rustychris/minictd/README.md

# minictd
Hardware and firmware for miniature, low-fi CTD
