rustychris/minictd/hardware/housings/pvc-1.25inch.fcstd

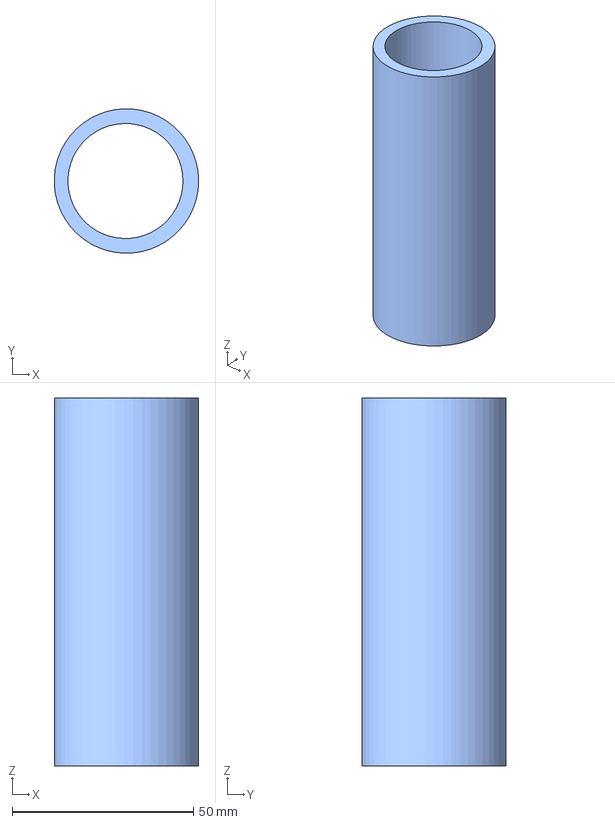
[picture p1: CAD file, 2018-12-10]
hardware/housings/pvc-1.25inch.fcstd
39.8 x 39.9 x 101.6 mm
