rustychris/minictd/hardware/parts/Battery Samsung ICR 18650 -22E.step

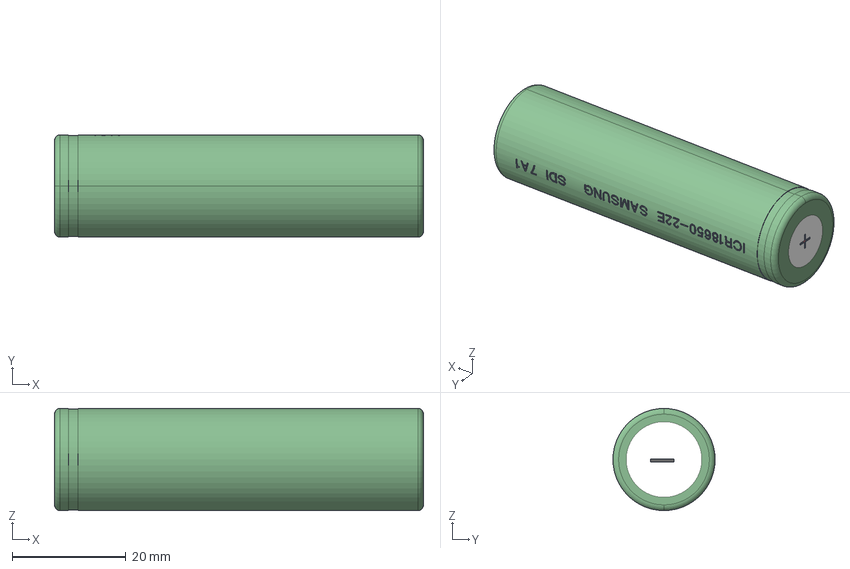
[picture p2: CAD file, 2018-11-28]
hardware/parts/Battery Samsung ICR 18650 -22E.step
65.0 x 18.0 x 18.0 mm
