rustychris/minictd/hardware/parts/Micro SD Card.STEP

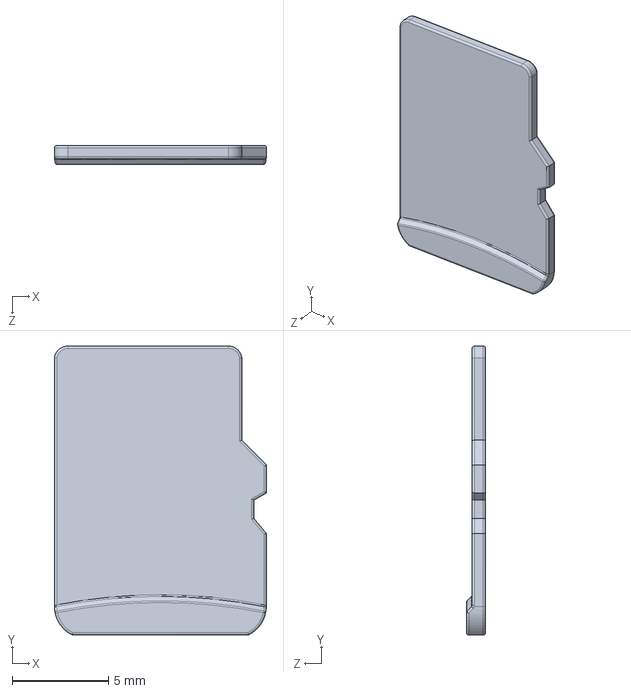
[picture p3: CAD file, 2018-11-28]
hardware/parts/Micro SD Card.STEP
11.0 x 15.0 x 1.00 mm
