rustychris/minictd/hardware/parts/keystone-PN500.STEP

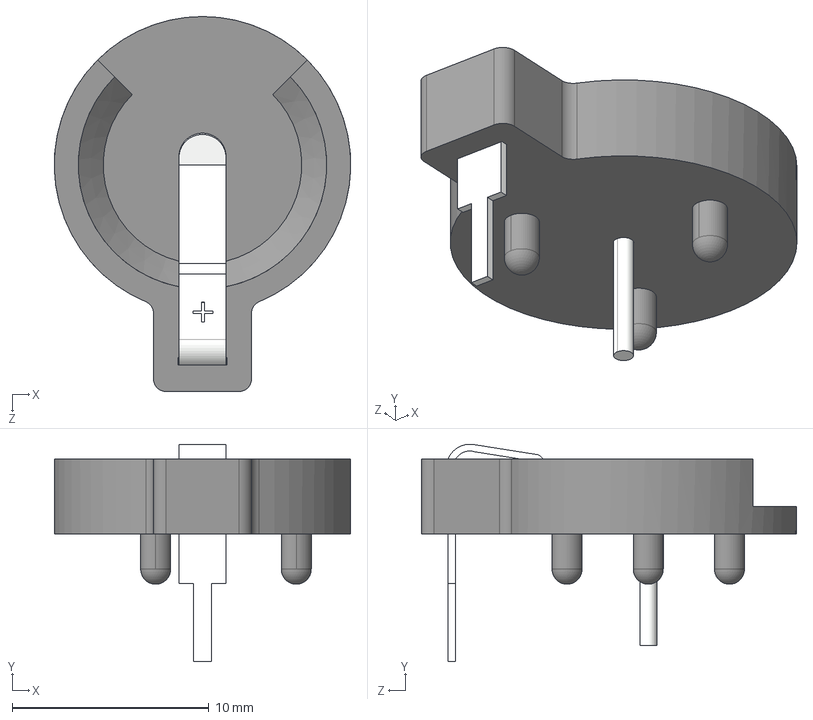
[picture p4: CAD file, 2018-11-28]
hardware/parts/keystone-PN500.STEP
15.1 x 11.0 x 19.1 mm
