rustychris/minictd/hardware/parts/Adafruit_BNO055_AP203.STEP

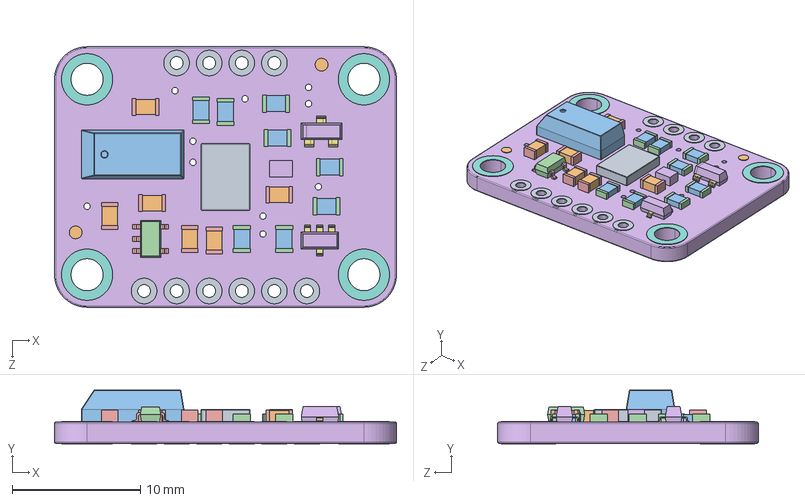
[picture p5: CAD file, 2018-11-28]
hardware/parts/Adafruit_BNO055_AP203.STEP
26.7 x 4.20 x 20.3 mm
