rustychris/minictd/hardware/parts/3727 ItsyBitsy M0.step

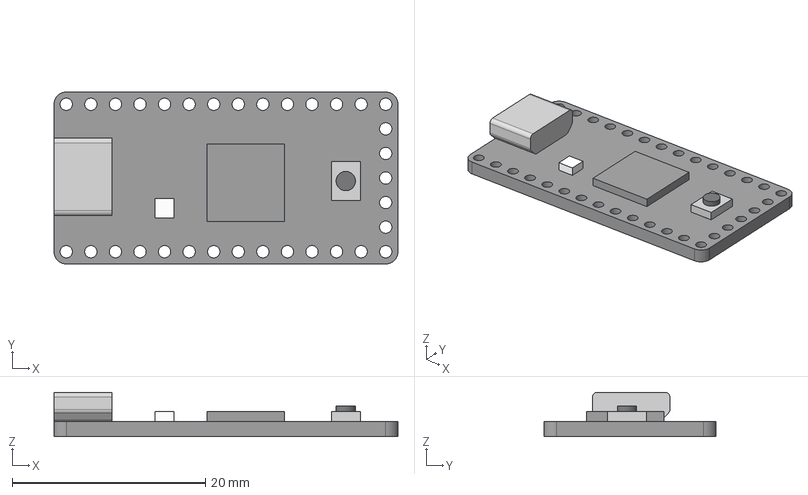
[picture p6: CAD file, 2018-11-28]
hardware/parts/3727 ItsyBitsy M0.step
35.6 x 17.8 x 4.60 mm
