rustychris/minictd/hardware/parts/DM3AT-SF-PEJM5.step

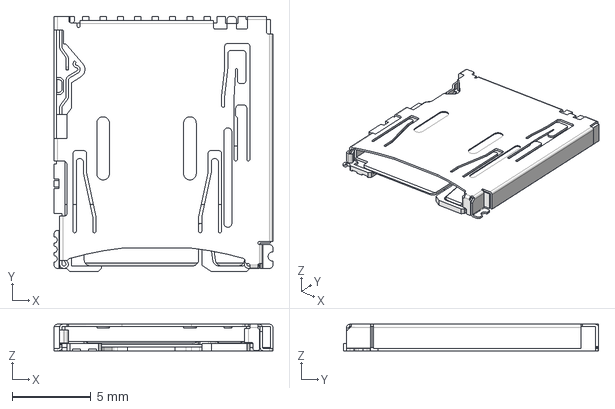
[picture p7: CAD file, 2018-11-28]
hardware/parts/DM3AT-SF-PEJM5.step
13.8 x 16.2 x 1.68 mm
