rustychris/minictd/(list of files, cad)

Other CAD files:
hardware/boards/m0_logger/keystone-PN500.STEP
