rustychris/minictd/(threads)

Thread 2 (2019-03-21):

Cruft at start of file

rustychris, 2019-03-21:
Data files often have a few samples (partial up to 4.5 lines ~ 500 bytes) at the start, like they were left in the buffer.

rustychris, 2019-03-21:
This may be fixed by using storage.cleanup() when exiting the loop instead of storage.loop().

rustychris, 2019-03-22:
Yes - fixed.

rustychris, 2019-03-22:
6635099d8f7a5920c75dd3f60d3d9767ccb64a09

Closed 2019-03-22.

Thread 3 (2019-03-22):

motor position invalid after exiting sample loop

rustychris, 2019-03-22:
the update mechanism is no longer polled, so we get wildly inaccurate negative values.
