rustychris/minictd/hardware/boards/logger/logger-pcb-back.pdf

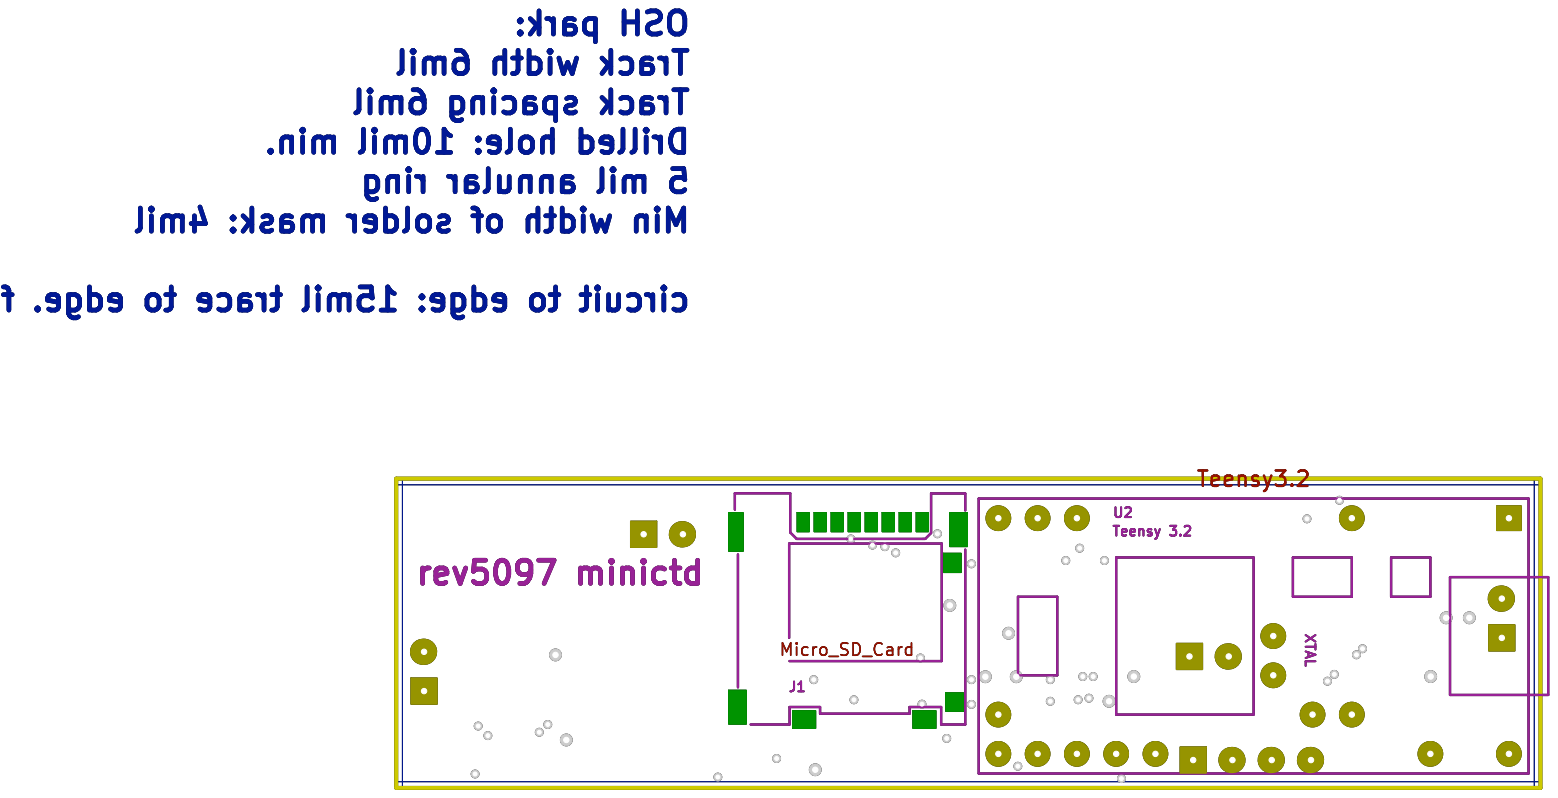
[picture p8: page 1]
