rustychris/minictd/hardware/boards/logger/logger-pcb-front.pdf

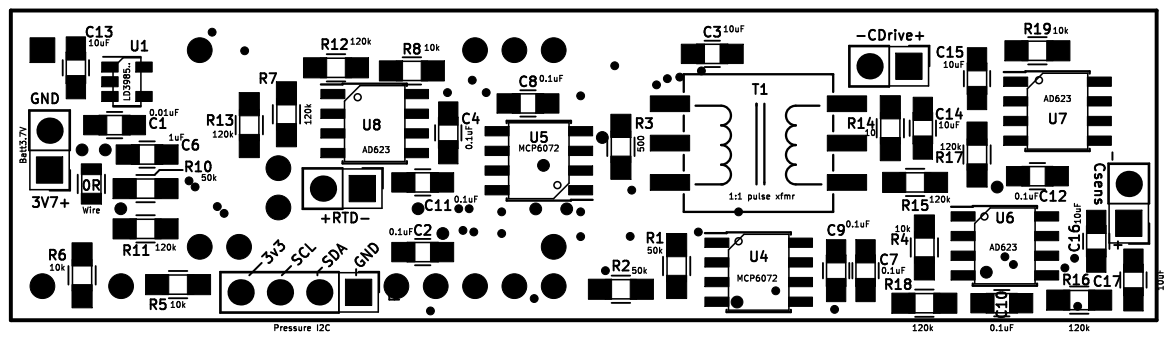
[picture p9: page 1]
