rustychris/minictd/hardware/boards/logger/logger-pcb.pdf

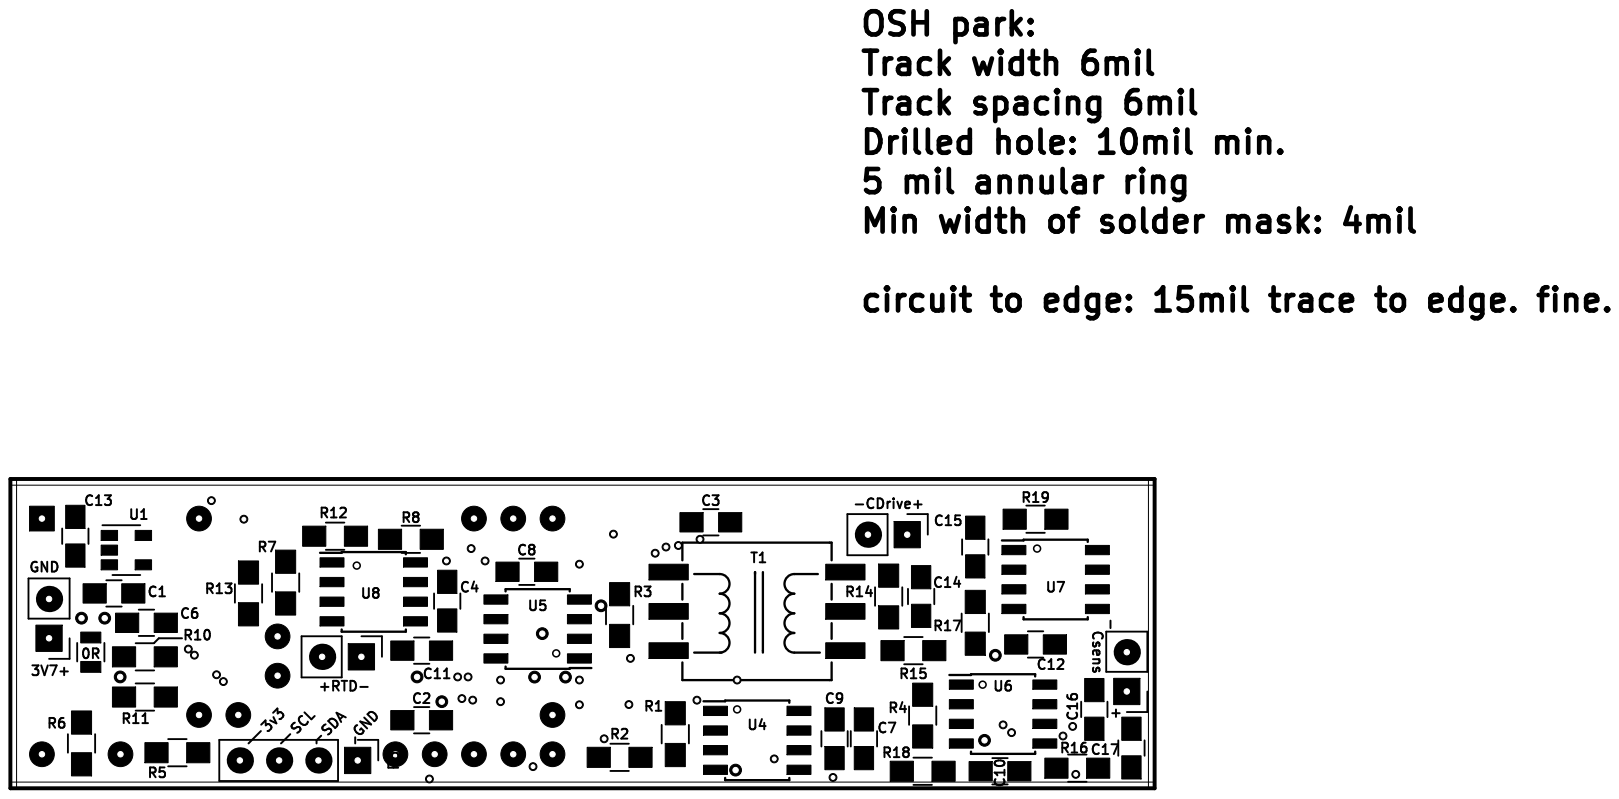
[picture p10: page 1]
