rustychris/minictd/hardware/boards/logger/logger-schematic.pdf

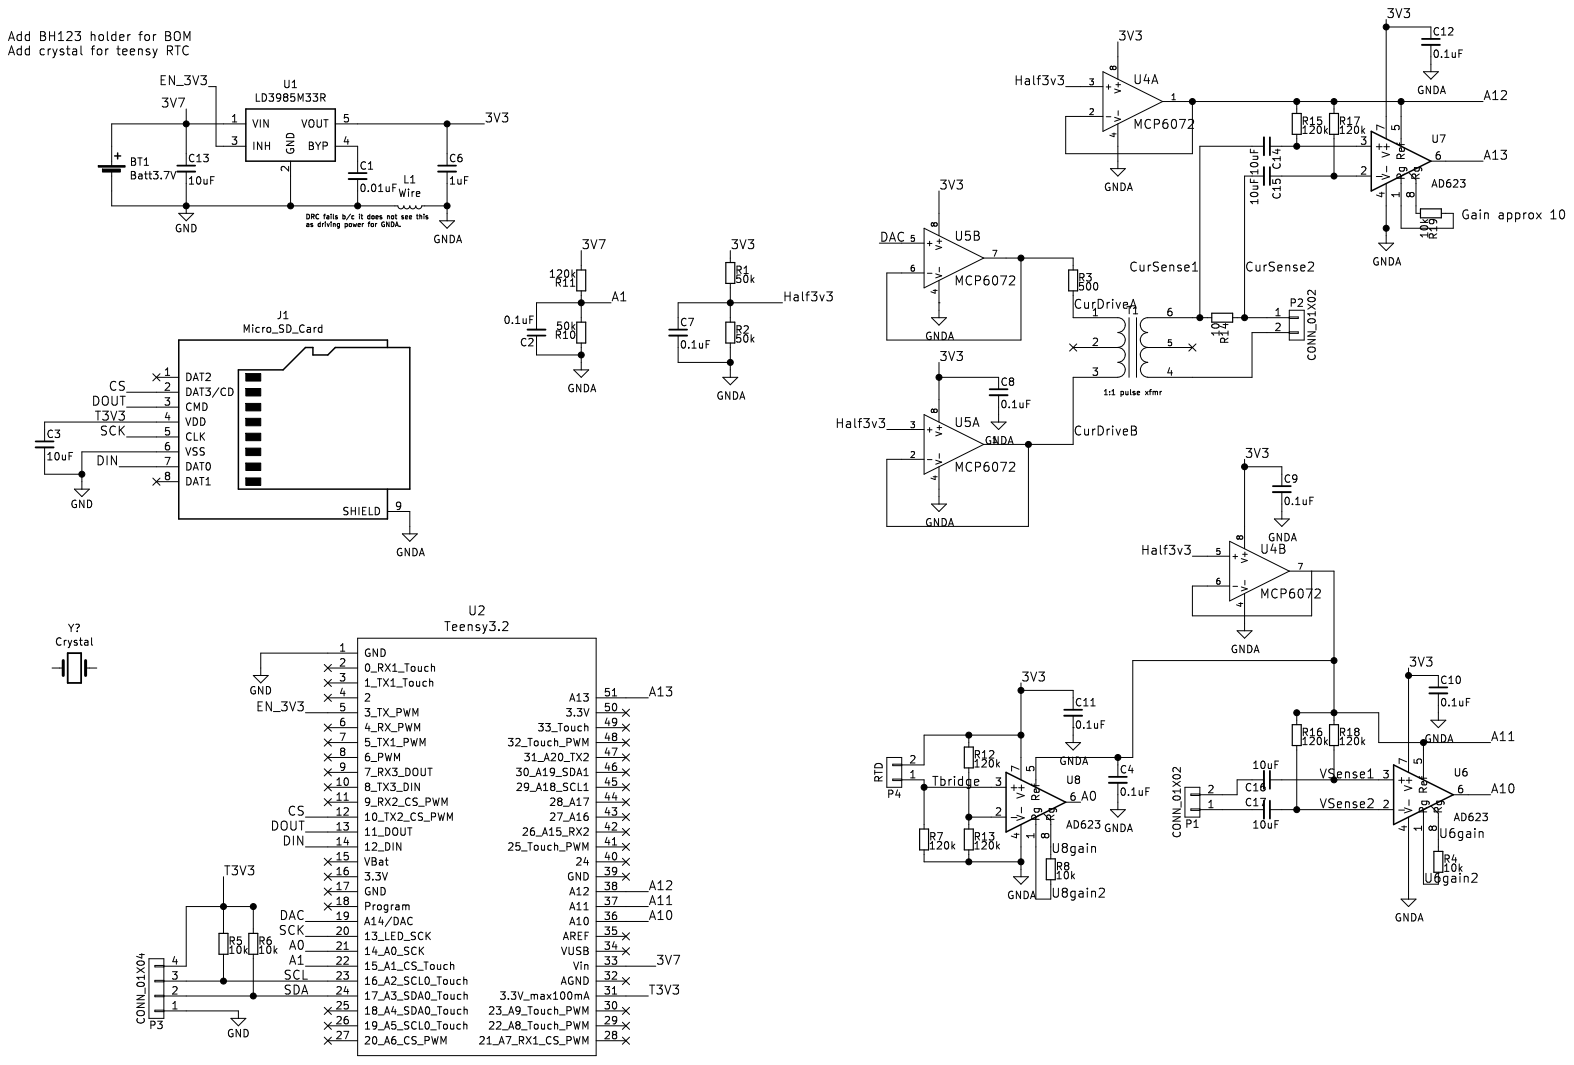
[picture p11: page 1]
