rustychris/minictd/(list of files, drawings)

Other design files:
hardware/boards/logger/logger_01.dsn
