rustychris/minictd/hardware/boards/m0_logger/m0_logger/m0_logger.kicad_pcb

## KiCad design hardware/boards/m0_logger/m0_logger/m0_logger.kicad_pcb (2018-12-20)

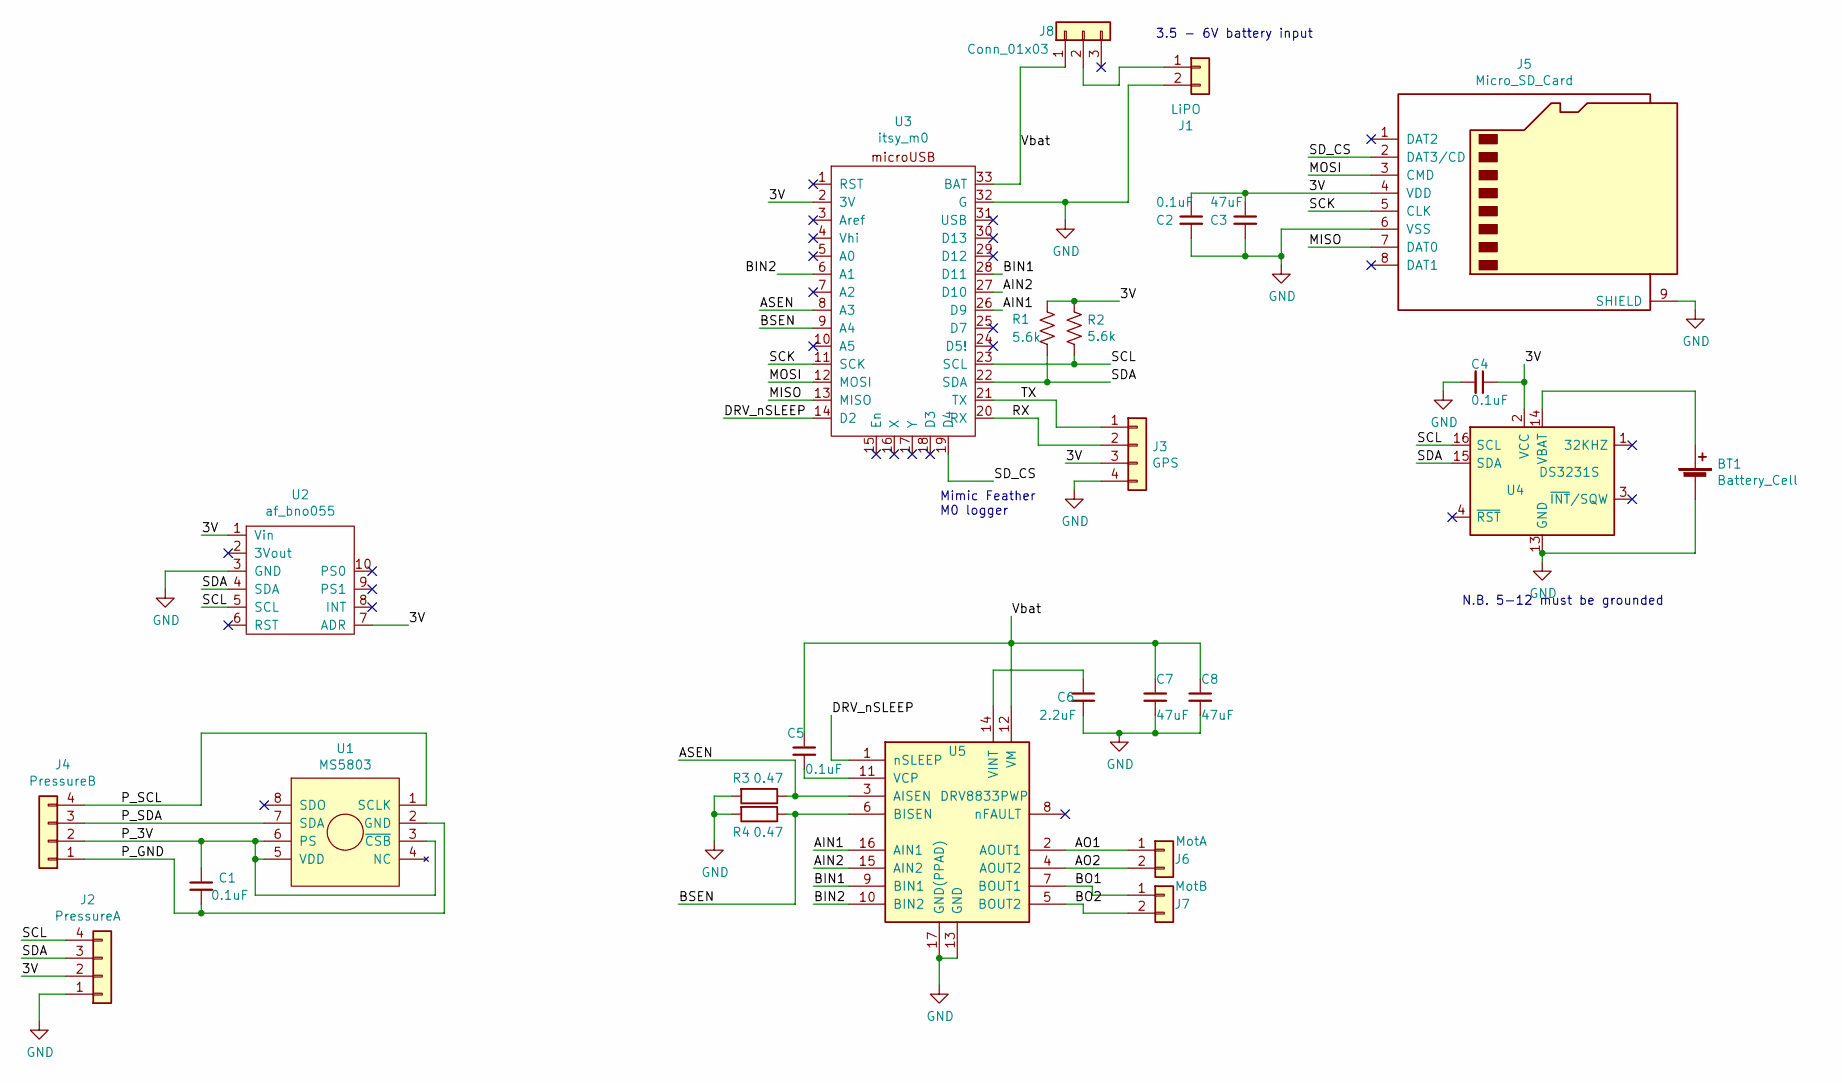
[picture p12: schematic m0_logger.sch]

Parts:
BT1: Battery_Cell; BatteryHolder_Keystone_500
C1, C2, C4, C5: 0.1uF; C_0805_2012Metric_Pad1.15x1.40mm_HandSolder
C3, C7, C8: 47uF; C_0805_2012Metric_Pad1.15x1.40mm_HandSolder
C6: 2.2uF; C_0805_2012Metric_Pad1.15x1.40mm_HandSolder
J1: LiPO; JST_PH_S2B-PH-K_1x02_P2.00mm_Horizontal
J2: PressureA; Molex_PicoBlade_53047-0810_1x04_P1.25mm_Vertical
J3: GPS; Molex_PicoBlade_53047-0810_1x04_P1.25mm_Vertical
J4: PressureB; PinHeader_1x04_P2.54mm_Vertical
J5: Micro_SD_Card; microSD_HC_Hirose_DM3AT-SF-PEJM5
J6: MotA; Molex_PicoBlade_53047-0410_1x02_P1.25mm_Vertical
J7: MotB; Molex_PicoBlade_53047-0410_1x02_P1.25mm_Vertical
J8: Conn_01x03; PinHeader_1x03_P2.54mm_Vertical
R1, R2: 5.6k; R_0805_2012Metric_Pad1.15x1.40mm_HandSolder
R3, R4: 0.47; R_0805_2012Metric_Pad1.15x1.40mm_HandSolder
U1: MS5803; ms5803_rh
U2: af_bno055; afBNO055
U3: itsy_m0; ItsyBitsyM0
U4: DS3231S; SOIC-16W_7.5x10.3mm_P1.27mm
U5: DRV8833PWP; HTSSOP-16-1EP_4.4x5mm_P0.65mm_EP3.4x5mm_Mask2.46x2.31mm_The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

Connections:
/3V: C2.1, C3.1, C4.1, J2.2, J3.3, J5.4 (VDD), R1.1, R2.1, U2.1 (Vin), U2.7 (ADR), U3.2 (3V), U4.2 (VCC)
/AIN1: U3.26 (D9), U5.16 (AIN1)
/AIN2: U3.27 (D10), U5.15 (AIN2)
/AO1: J6.1, U5.2 (AOUT1)
/AO2: J6.2, U5.4 (AOUT2)
/ASEN: R3.1, U3.8 (A3), U5.3 (AISEN)
/BIN1: U3.28 (D11), U5.9 (BIN1)
/BIN2: U3.6 (A1), U5.10 (BIN2)
/BO1: J7.1, U5.7 (BOUT1)
/BO2: J7.2, U5.5 (BOUT2)
/BSEN: R4.1, U3.9 (A4), U5.6 (BISEN)
/DRV_nSLEEP: U3.14 (D2), U5.1 (nSLEEP)
/MISO: J5.7 (DAT0), U3.13 (MISO)
/MOSI: J5.3 (CMD), U3.12 (MOSI)
/P_3V: C1.1, J4.2, U1.3 (~CSB~), U1.5 (VDD), U1.6 (PS); also elsewhere on the board
/P_GND: C1.2, J4.1, U1.2 (GND); also elsewhere on the board
/P_SCL: J4.4, U1.1 (SCLK); also elsewhere on the board
/P_SDA: J4.3, U1.7 (SDA); also elsewhere on the board
/RX: J3.2, U3.20 (RX)
/SCK: J5.5 (CLK), U3.11 (SCK)
/SCL: J2.4, R2.2, U2.5 (SCL), U3.23 (SCL), U4.16 (SCL)
/SDA: J2.3, R1.2, U2.4 (SDA), U3.22 (SDA), U4.15 (SDA)
/SD_CS: J5.2 (DAT3/CD), U3.19 (D4)
/TX: J3.1, U3.21 (TX)
/Vbat: C5.1, C7.1, C8.1, J8.1, U3.33 (BAT), U5.12 (VM)
GND: BT1.2 (-), C2.2, C3.2, C4.2, C6.2, C7.2, C8.2, J1.2, J2.1, J3.4, J5.6 (VSS), J5.9 (SHIELD), R3.2, R4.2, U2.3 (GND), U3.32 (G), U4.5 (GND), U4.6 (GND), U4.7 (GND), U4.8 (GND), U4.9 (GND), U4.10 (GND), U4.11 (GND), U4.12 (GND), U4.13 (GND), U5.13 (GND), U5.17 (GND(PPAD))
unnamed: BT1.1 (+), U4.14 (VBAT)
unnamed: C5.2, U5.11 (VCP)
unnamed: C6.1, U5.14 (VINT)
unnamed: J1.1, J8.2

Notes on the sheet:
N.B. 5-12 must be grounded
Mimic Feather M0 logger
3.5 - 6V battery input

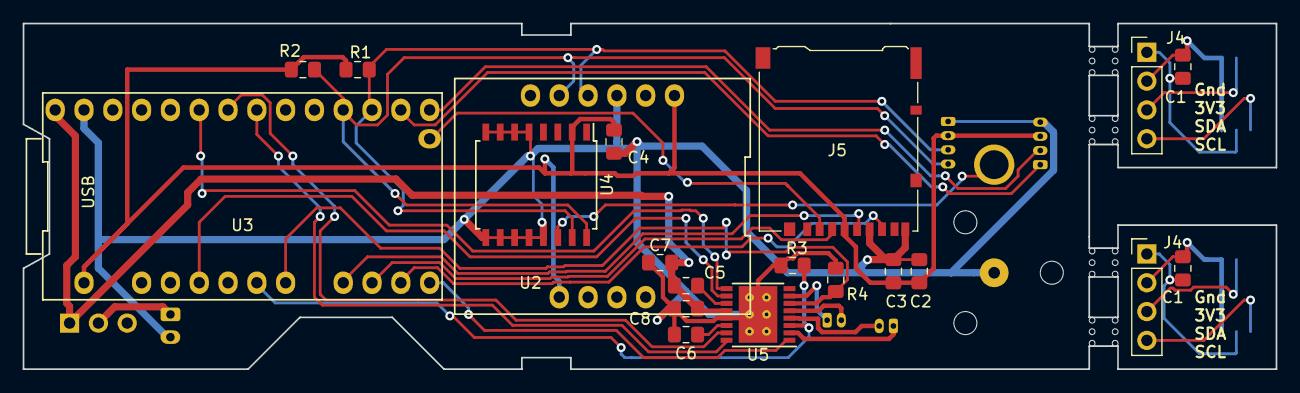
[picture p13: board m0_logger.kicad_pcb from above]

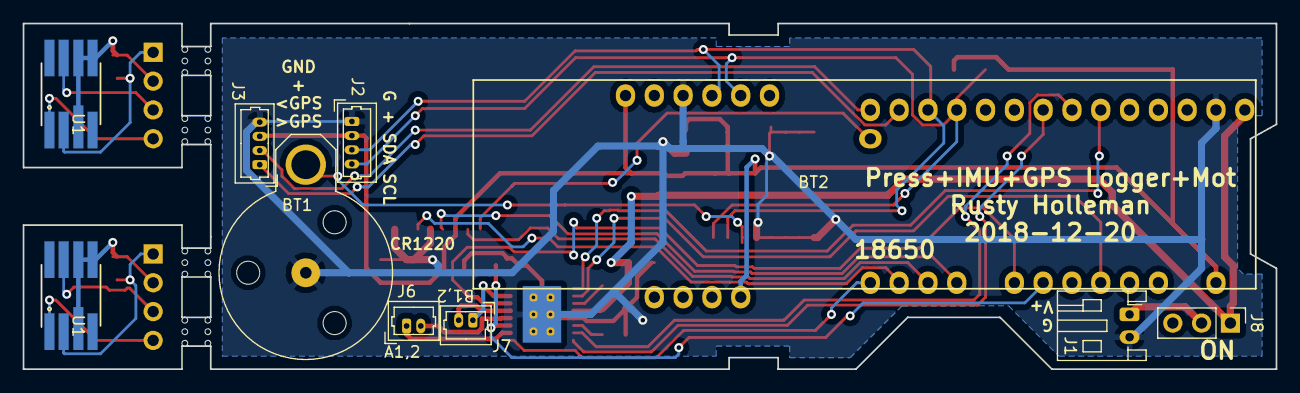
[picture p14: board m0_logger.kicad_pcb from below]

Board: 2 copper layers, 110.5 x 30.5 mm, 30 parts (10 on the bottom side), 30 nets.

Other parts of the board:
BT2: 18650, protected; af18650_outline
C1#2: 0.1uF; C_0805_2012Metric_Pad1.15x1.40mm_HandSolder
J4#2: PressureB; PinHeader_1x04_P2.54mm_Vertical
U1#2: MS5803; ms5803_rh

Their connections:
/P_3V: C1#2.1, J4#2.2, U1#2.3, U1#2.5, U1#2.6; also elsewhere on the board
/P_GND: C1#2.2, J4#2.1, U1#2.2; also elsewhere on the board
/P_SCL: J4#2.4, U1#2.1; also elsewhere on the board
/P_SDA: J4#2.3, U1#2.7; also elsewhere on the board
