rustychris/minictd/hardware/boards/logger/logger_01.kicad_pcb

## KiCad design hardware/boards/logger/logger_01.kicad_pcb (2017-07-04)

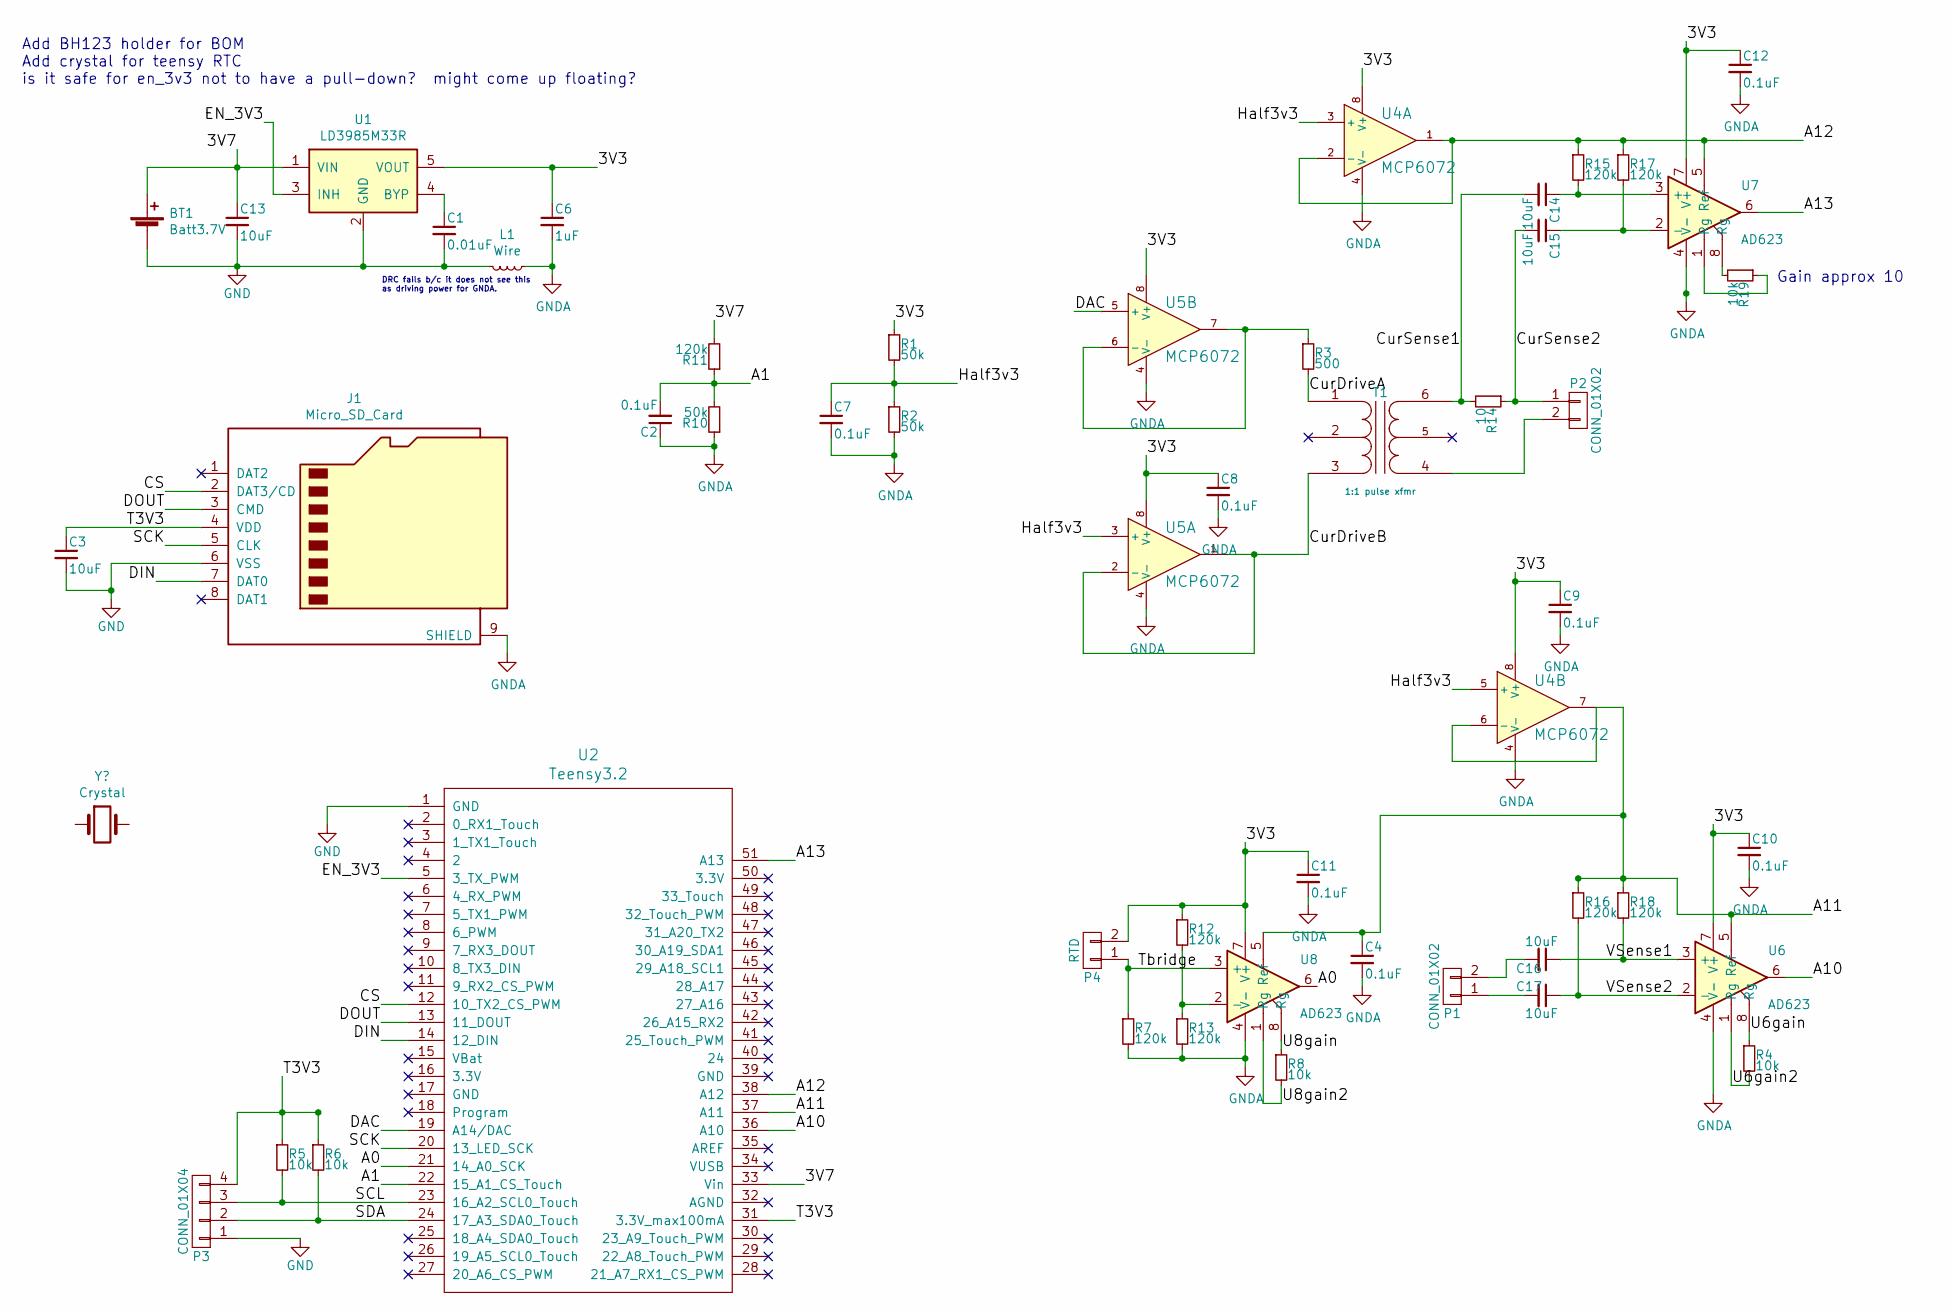
[picture p15: schematic logger_01.sch]

Parts:
BT1: Batt3.7V; Pin_Header_Straight_1x02_Pitch2.54mm
C1: 0.01uF; C_0805_HandSoldering; part_num CC0805KRX7R9BB103; digikey_num 311-1136-1-ND
C2, C7: 0.1uF; C_0805_HandSoldering; part_num 08055C104KAT2A; digikey_num 478-1395-1-ND
C3, C13, C14, C15, C16, C17: 10uF; C_0805_HandSoldering; part_num GRM21BR61E106KA73L; digikey_num 490-5523-1-ND
C4, C8, C9, C10, C11, C12: 0.1uF; C_0805_HandSoldering; part_num 08055C104KAT2A
C6: 1uF; C_0805_HandSoldering; part_num GRM21BR61E106KA73L; digikey_num 490-5523-1-ND
J1: Micro_SD_Card; molex5031821852; part_num 5031821852; digikey_num WM12834CT-ND
L1: Wire; R_0805
P1, P2: CONN_01X02; Pin_Header_Straight_1x02_Pitch2.54mm
P3: CONN_01X04; Pin_Header_Straight_1x04_Pitch2.54mm; part_num S1011EC-12-ND; digikey_num PRPC012SAAN-RC
P4: RTD; Pin_Header_Straight_1x02_Pitch2.54mm
R1, R2, R10: 50k; R_0805_HandSoldering; part_num RT0805DRE0722K1L; digikey_num 311-2825-1-ND
R3: 500; R_0805_HandSoldering; part_num RR1220P-471-D; digikey_num RR12P470DCT-ND
R4, R6, R8, R19: 10k; R_0805_HandSoldering; part_num RT0805DRD0712K1L
R5: 10k; R_0805_HandSoldering; part_num RT0805DRD0712K1L; digikey_num 311-2703-1-ND
R7, R12, R13, R15, R16, R17, R18: 120k; R_0805_HandSoldering; part_num RT0805DRD07120KL; digikey_num 311-2702-1-ND
R11: 120k; R_0805_HandSoldering; part_num RT0805DRE0722K1L; digikey_num 311-2825-1-ND
R14: 10; R_0805_HandSoldering; part_num RT0805DRD0710RL; digikey_num 311-2700-1-ND
T1: 1:1 pulse xfmr; 6pin_pulse_transformer; part_num 78253/55JC; digikey_num 811-2415-ND
U1: LD3985M33R; SOT-23-5; part_num LD3985M33R; digikey_num 497-3504-1-ND
U2: Teensy3.2; Teensy32_for_logger
U4: MCP6072; SOIC-8_3.9x4.9mm_Pitch1.27mm; part_num MCP6072-E/SN; digikey MCP6072-E/SN-ND
U5: MCP6072; SOIC-8_3.9x4.9mm_Pitch1.27mm; part_num MCP6072-E/SN; digikey_num MCP6072-E/SN-ND
U6, U7, U8: AD623; SOIC-8_3.9x4.9mm_Pitch1.27mm; part_num AD623ARZ; digikey_num AD623ARZ-ND

Connections:
/3V3: C6.1, C8.1, C9.1, C10.1, C11.1, C12.1, P4.2, R1.1, R12.1, U1.5 (VOUT), U4.8 (V+), U5.8 (V+), U6.7 (V+), U7.7 (V+), U8.7 (V+)
/3V7: BT1.1 (+), C13.1, R11.2, U1.1 (VIN), U2.33 (Vin)
/A0: U2.21 (14_A0_SCK), U8.6
/A1: C2.2, R10.2, R11.1, U2.22 (15_A1_CS_Touch)
/A10: U2.36 (A10), U6.6
/A11: C4.1, R16.1, R18.1, U2.37 (A11), U4.6 (-), U4.7, U6.5 (Ref), U8.5 (Ref)
/A12: R15.1, R17.1, U2.38 (A12), U4.1, U4.2 (-), U7.5 (Ref)
/A13: U2.51 (A13), U7.6
/CS: J1.2 (DAT3/CD), U2.12 (10_TX2_CS_PWM)
/CurDriveA: R3.2, T1.1 (PR1)
/CurDriveB: T1.3 (PR2), U5.1, U5.2 (-)
/CurSense1: C14.2, R14.2, T1.6 (S2)
/CurSense2: C15.2, P2.1, R14.1
/DAC: U2.19 (A14/DAC), U5.5 (+)
/DIN: J1.7 (DAT0), U2.14 (12_DIN)
/DOUT: J1.3 (CMD), U2.13 (11_DOUT)
/EN_3V3: U1.3 (INH), U2.5 (3_TX_PWM)
/Half3v3: C7.1, R1.2, R2.1, U4.3 (+), U4.5 (+), U5.3 (+)
/SCK: J1.5 (CLK), U2.20 (13_LED_SCK)
/SCL: P3.3, R5.2, U2.23 (16_A2_SCL0_Touch)
/SDA: P3.2, R6.2, U2.24 (17_A3_SDA0_Touch)
/T3V3: C3.1, J1.4 (VDD), P3.4, R5.1, R6.1, U2.31 (3.3V_max100mA)
/Tbridge: P4.1, R7.1, U8.3 (+)
/U6gain: R4.1, U6.8 (Rg)
/U6gain2: R4.2, U6.1 (Rg)
/U8gain: R8.1, U8.8 (Rg)
/U8gain2: R8.2, U8.1 (Rg)
/VSense1: C16.1, R18.2, U6.3 (+)
/VSense2: C17.1, R16.2, U6.2 (-)
GND: BT1.2 (-), C1.2, C3.2, C13.2, J1.6 (VSS), L1.2, P3.1, U1.2 (GND), U2.1 (GND); also elsewhere on the board
GNDA: C2.1, C4.2, C6.2, C7.2, C8.2, C9.2, C10.2, C11.2, C12.2, J1.9 (SHIELD), L1.1, R2.2, R7.2, R10.1, R13.2, U4.4 (V-), U5.4 (V-), U6.4 (V-), U7.4 (V-), U8.4 (V-); also elsewhere on the board
unnamed: C1.1, U1.4 (BYP)
unnamed: C14.1, R15.2, U7.3 (+)
unnamed: C15.1, R17.2, U7.2 (-)
unnamed: C16.2, P1.2
unnamed: C17.2, P1.1
unnamed: P2.2, T1.4 (S1)
unnamed: R3.1, U5.6 (-), U5.7
unnamed: R12.2, R13.1, U8.2 (-)
unnamed: R19.1, U7.1 (Rg)
unnamed: R19.2, U7.8 (Rg)

Notes on the sheet:
Gain approx 10
DRC fails b/c it does not see this as driving power for GNDA.
Add BH123 holder for BOM Add crystal for teensy RTC is it safe for en_3v3 not to have a pull-down? might come up floating?

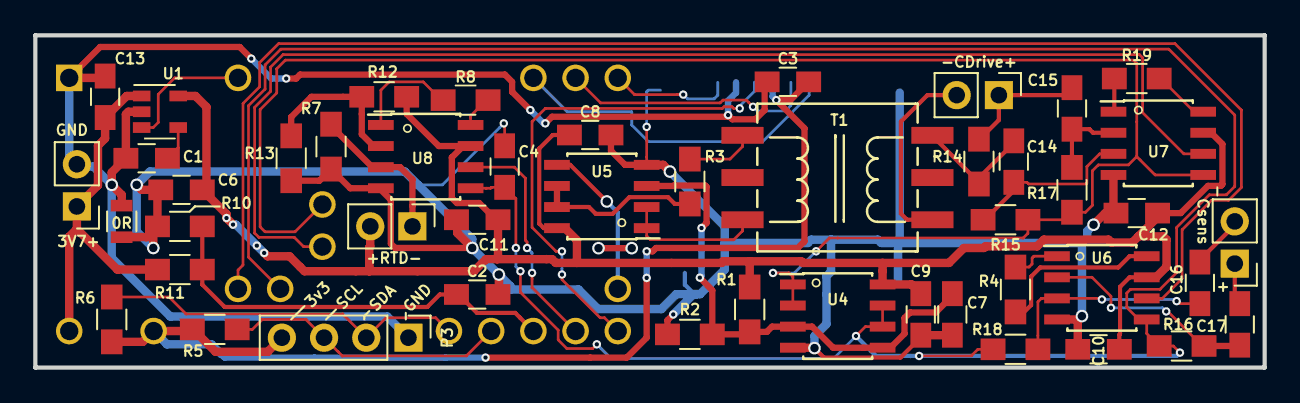
[picture p16: board logger_01.kicad_pcb from above]

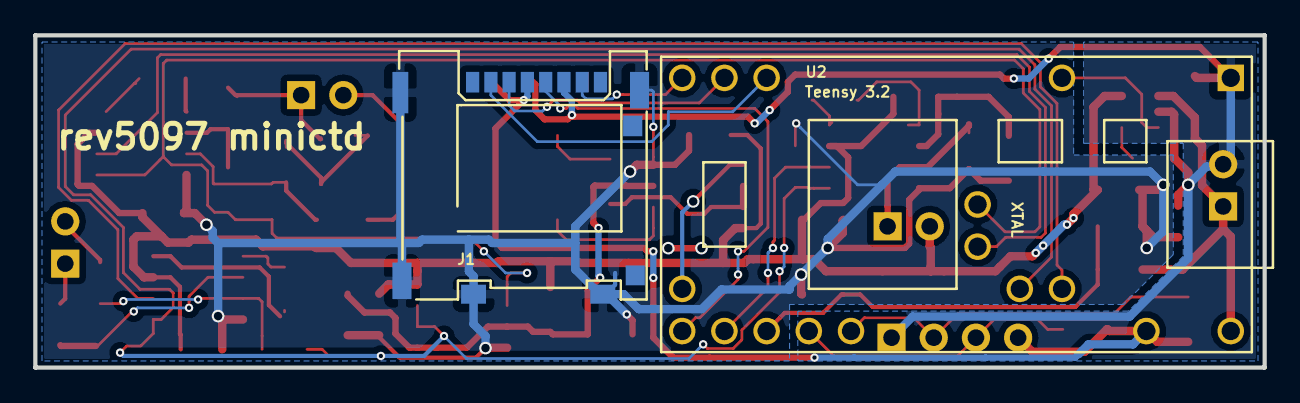
[picture p17: board logger_01.kicad_pcb from below]

Board: 2 copper layers, 74.0 x 20.0 mm, 49 parts (2 on the bottom side), 41 nets.

Other parts of the board:
0R: Wire; R_0805

Their connections:
GND: 0R.2; also elsewhere on the board
GNDA: 0R.1; also elsewhere on the board
