rustychris/minictd/software/xmodem.py

'''
Originally cloned from:
https://github.com/tehmaze/xmodem
Adapted for use with miniterm by Rusty Holleman

===============================
 XMODEM file transfer protocol
===============================

.. $Id$

This is a literal implementation of XMODEM.TXT_, XMODEM1K.TXT_ and
XMODMCRC.TXT_, support for YMODEM and ZMODEM is pending. YMODEM should
be fairly easy to implement as it is a hack on top of the XMODEM
protocol using sequence bytes ``0x00`` for sending file names (and some
meta data).

.. _XMODEM.TXT: doc/XMODEM.TXT
.. _XMODEM1K.TXT: doc/XMODEM1K.TXT
.. _XMODMCRC.TXT: doc/XMODMCRC.TXT

Data flow example including error recovery
==========================================

Here is a sample of the data flow, sending a 3-block message.
It includes the two most common line hits - a garbaged block,
and an ``ACK`` reply getting garbaged. ``CRC`` or ``CSUM`` represents
the checksum bytes.

XMODEM 128 byte blocks
----------------------

::

    SENDER                                      RECEIVER

                                            <-- NAK
    SOH 01 FE Data[128] CSUM                -->
                                            <-- ACK
    SOH 02 FD Data[128] CSUM                -->
                                            <-- ACK
    SOH 03 FC Data[128] CSUM                -->
                                            <-- ACK
    SOH 04 FB Data[128] CSUM                -->
                                            <-- ACK
    SOH 05 FA Data[100] CPMEOF[28] CSUM     -->
                                            <-- ACK
    EOT                                     -->
                                            <-- ACK

XMODEM-1k blocks, CRC mode
--------------------------

::

    SENDER                                      RECEIVER

                                            <-- C
    STX 01 FE Data[1024] CRC CRC            -->
                                            <-- ACK
    STX 02 FD Data[1024] CRC CRC            -->
                                            <-- ACK
    STX 03 FC Data[1000] CPMEOF[24] CRC CRC -->
                                            <-- ACK
    EOT                                     -->
                                            <-- ACK

Mixed 1024 and 128 byte Blocks
------------------------------

::

    SENDER                                      RECEIVER

                                            <-- C
    STX 01 FE Data[1024] CRC CRC            -->
                                            <-- ACK
    STX 02 FD Data[1024] CRC CRC            -->
                                            <-- ACK
    SOH 03 FC Data[128] CRC CRC             -->
                                            <-- ACK
    SOH 04 FB Data[100] CPMEOF[28] CRC CRC  -->
                                            <-- ACK
    EOT                                     -->
                                            <-- ACK

YMODEM Batch Transmission Session (1 file)
------------------------------------------

::

    SENDER                                      RECEIVER
                                            <-- C (command:rb)
    SOH 00 FF foo.c NUL[123] CRC CRC        -->
                                            <-- ACK
                                            <-- C
    SOH 01 FE Data[128] CRC CRC             -->
                                            <-- ACK
    SOH 02 FC Data[128] CRC CRC             -->
                                            <-- ACK
    SOH 03 FB Data[100] CPMEOF[28] CRC CRC  -->
                                            <-- ACK
    EOT                                     -->
                                            <-- NAK
    EOT                                     -->
                                            <-- ACK
                                            <-- C
    SOH 00 FF NUL[128] CRC CRC              -->
                                            <-- ACK


'''
from __future__ import division, print_function

__author__ = 'Wijnand Modderman <maze@pyth0n.org>'
__copyright__ = ['Copyright (c) 2010 Wijnand Modderman',
                 'Copyright (c) 1981 Chuck Forsberg']
__license__ = 'MIT'
__version__ = '0.4.5'

import os
import platform
import logging
import time
import sys
from functools import partial

# Protocol bytes
SOH = b'\x01'
STX = b'\x02'
EOT = b'\x04'
ACK = b'\x06'
DLE = b'\x10'
NAK = b'\x15'
CAN = b'\x18'
CRC = b'C'


class XMODEM(object):
    '''
    XMODEM Protocol handler, expects two callables which encapsulate the read
        and write operations on the underlying stream.

    Example functions for reading and writing to a serial line:

    >>> import serial
    >>> from xmodem import XMODEM
    >>> ser = serial.Serial('/dev/ttyUSB0', timeout=0) # or whatever you need
    >>> def getc(size, timeout=1):
    ...     return ser.read(size) or None
    ...
    >>> def putc(data, timeout=1):
    ...     return ser.write(data) or None
    ...
    >>> modem = XMODEM(getc, putc)


    :param getc: Function to retrieve bytes from a stream. The function takes
        the number of bytes to read from the stream and a timeout in seconds as
        parameters. It must return the bytes which were read, or ``None`` if a
        timeout occured.
    :type getc: callable
    :param putc: Function to transmit bytes to a stream. The function takes the
        bytes to be written and a timeout in seconds as parameters. It must
        return the number of bytes written to the stream, or ``None`` in case of
        a timeout.
    :type putc: callable
    :param mode: XMODEM protocol mode
    :type mode: string
    :param pad: Padding character to make the packets match the packet size
    :type pad: char

    '''

    # crctab calculated by Mark G. Mendel, Network Systems Corporation
    crctable = [
        0x0000, 0x1021, 0x2042, 0x3063, 0x4084, 0x50a5, 0x60c6, 0x70e7,
        0x8108, 0x9129, 0xa14a, 0xb16b, 0xc18c, 0xd1ad, 0xe1ce, 0xf1ef,
        0x1231, 0x0210, 0x3273, 0x2252, 0x52b5, 0x4294, 0x72f7, 0x62d6,
        0x9339, 0x8318, 0xb37b, 0xa35a, 0xd3bd, 0xc39c, 0xf3ff, 0xe3de,
        0x2462, 0x3443, 0x0420, 0x1401, 0x64e6, 0x74c7, 0x44a4, 0x5485,
        0xa56a, 0xb54b, 0x8528, 0x9509, 0xe5ee, 0xf5cf, 0xc5ac, 0xd58d,
        0x3653, 0x2672, 0x1611, 0x0630, 0x76d7, 0x66f6, 0x5695, 0x46b4,
        0xb75b, 0xa77a, 0x9719, 0x8738, 0xf7df, 0xe7fe, 0xd79d, 0xc7bc,
        0x48c4, 0x58e5, 0x6886, 0x78a7, 0x0840, 0x1861, 0x2802, 0x3823,
        0xc9cc, 0xd9ed, 0xe98e, 0xf9af, 0x8948, 0x9969, 0xa90a, 0xb92b,
        0x5af5, 0x4ad4, 0x7ab7, 0x6a96, 0x1a71, 0x0a50, 0x3a33, 0x2a12,
        0xdbfd, 0xcbdc, 0xfbbf, 0xeb9e, 0x9b79, 0x8b58, 0xbb3b, 0xab1a,
        0x6ca6, 0x7c87, 0x4ce4, 0x5cc5, 0x2c22, 0x3c03, 0x0c60, 0x1c41,
        0xedae, 0xfd8f, 0xcdec, 0xddcd, 0xad2a, 0xbd0b, 0x8d68, 0x9d49,
        0x7e97, 0x6eb6, 0x5ed5, 0x4ef4, 0x3e13, 0x2e32, 0x1e51, 0x0e70,
        0xff9f, 0xefbe, 0xdfdd, 0xcffc, 0xbf1b, 0xaf3a, 0x9f59, 0x8f78,
        0x9188, 0x81a9, 0xb1ca, 0xa1eb, 0xd10c, 0xc12d, 0xf14e, 0xe16f,
        0x1080, 0x00a1, 0x30c2, 0x20e3, 0x5004, 0x4025, 0x7046, 0x6067,
        0x83b9, 0x9398, 0xa3fb, 0xb3da, 0xc33d, 0xd31c, 0xe37f, 0xf35e,
        0x02b1, 0x1290, 0x22f3, 0x32d2, 0x4235, 0x5214, 0x6277, 0x7256,
        0xb5ea, 0xa5cb, 0x95a8, 0x8589, 0xf56e, 0xe54f, 0xd52c, 0xc50d,
        0x34e2, 0x24c3, 0x14a0, 0x0481, 0x7466, 0x6447, 0x5424, 0x4405,
        0xa7db, 0xb7fa, 0x8799, 0x97b8, 0xe75f, 0xf77e, 0xc71d, 0xd73c,
        0x26d3, 0x36f2, 0x0691, 0x16b0, 0x6657, 0x7676, 0x4615, 0x5634,
        0xd94c, 0xc96d, 0xf90e, 0xe92f, 0x99c8, 0x89e9, 0xb98a, 0xa9ab,
        0x5844, 0x4865, 0x7806, 0x6827, 0x18c0, 0x08e1, 0x3882, 0x28a3,
        0xcb7d, 0xdb5c, 0xeb3f, 0xfb1e, 0x8bf9, 0x9bd8, 0xabbb, 0xbb9a,
        0x4a75, 0x5a54, 0x6a37, 0x7a16, 0x0af1, 0x1ad0, 0x2ab3, 0x3a92,
        0xfd2e, 0xed0f, 0xdd6c, 0xcd4d, 0xbdaa, 0xad8b, 0x9de8, 0x8dc9,
        0x7c26, 0x6c07, 0x5c64, 0x4c45, 0x3ca2, 0x2c83, 0x1ce0, 0x0cc1,
        0xef1f, 0xff3e, 0xcf5d, 0xdf7c, 0xaf9b, 0xbfba, 0x8fd9, 0x9ff8,
        0x6e17, 0x7e36, 0x4e55, 0x5e74, 0x2e93, 0x3eb2, 0x0ed1, 0x1ef0,
    ]

    ymodem=False
    abort_requested=False 
    
    def __init__(self, getc, putc, mode='xmodem', pad=b'\x1a'):
        self.getc = getc
        self.putc = putc
        self.mode = mode
        self.pad = pad
        self.log = logging.getLogger('xmodem.XMODEM')

    def abort(self, count=2, timeout=60):
        '''
        Send an abort sequence using CAN bytes.

        :param count: how many abort characters to send
        :type count: int
        :param timeout: timeout in seconds
        :type timeout: int
        '''
        for _ in range(count):
            self.putc(CAN, timeout)

    def send(self, stream, retry=16, timeout=60, quiet=False, callback=None):
        '''
        Send a stream via the XMODEM protocol.

            >>> stream = open('/etc/issue', 'rb')
            >>> print(modem.send(stream))
            True

        Returns ``True`` upon successful transmission or ``False`` in case of
        failure.

        :param stream: The stream object to send data from.
        :type stream: stream (file, etc.)
        :param retry: The maximum number of times to try to resend a failed
                      packet before failing.
        :type retry: int
        :param timeout: The number of seconds to wait for a response before
                        timing out.
        :type timeout: int
        :param quiet: If True, write transfer information to stderr.
        :type quiet: bool
        :param callback: Reference to a callback function that has the
                         following signature.  This is useful for
                         getting status updates while a xmodem
                         transfer is underway.
                         Expected callback signature:
                         def callback(total_packets, success_count, error_count)
        :type callback: callable
        '''

        # initialize protocol
        try:
            packet_size = dict(
                xmodem    = 128,
                xmodem1k  = 1024,
            )[self.mode]
        except KeyError:
            raise ValueError("Invalid mode specified: {self.mode!r}"
                             .format(self=self))

        self.log.debug('Begin start sequence, packet_size=%d', packet_size)
        error_count = 0
        crc_mode = 0
        cancel = 0
        while True:
            char = self.getc(1)
            if char:
                if char == NAK:
                    self.log.debug('standard checksum requested (NAK).')
                    crc_mode = 0
                    break
                elif char == CRC:
                    self.log.debug('16-bit CRC requested (CRC).')
                    crc_mode = 1
                    break
                elif char == CAN:
                    if not quiet:
                        print('received CAN', file=sys.stderr)
                    if cancel:
                        self.log.info('Transmission canceled: received 2xCAN '
                                      'at start-sequence')
                        return False
                    else:
                        self.log.debug('cancellation at start sequence.')
                        cancel = 1
                else:
                    self.log.error('send error: expected NAK, CRC, or CAN; '
                                   'got %r', char)

            error_count += 1
            if error_count > retry:
                self.log.info('send error: error_count reached %d, '
                              'aborting.', retry)
                self.abort(timeout=timeout)
                return False

        # send data
        error_count = 0
        success_count = 0
        total_packets = 0
        sequence = 1
        while True:
            data = stream.read(packet_size)
            if not data:
                # end of stream
                self.log.debug('send: at EOF')
                break
            total_packets += 1

            header = self._make_send_header(packet_size, sequence)
            data = data.ljust(packet_size, self.pad)
            checksum = self._make_send_checksum(crc_mode, data)

            # emit packet
            while True:
                self.log.debug('send: block %d', sequence)
                self.putc(header + data + checksum)
                char = self.getc(1, timeout)
                if char == ACK:
                    success_count += 1
                    if callable(callback):
                        callback(total_packets, success_count, error_count)
                    error_count = 0
                    break

                self.log.error('send error: expected ACK; got %r for block %d',
                               char, sequence)
                error_count += 1
                if callable(callback):
                    callback(total_packets, success_count, error_count)
                if error_count > retry:
                    # excessive amounts of retransmissions requested,
                    # abort transfer
                    self.log.error('send error: NAK received %d times, '
                                   'aborting.', error_count)
                    self.abort(timeout=timeout)
                    return False

            # keep track of sequence
            sequence = (sequence + 1) % 0x100

        while True:
            self.log.debug('sending EOT, awaiting ACK')
            # end of transmission
            self.putc(EOT)

            # An ACK should be returned
            char = self.getc(1, timeout)
            if char == ACK:
                break
            else:
                self.log.error('send error: expected ACK; got %r', char)
                error_count += 1
                if error_count > retry:
                    self.log.warn('EOT was not ACKd, aborting transfer')
                    self.abort(timeout=timeout)
                    return False

        self.log.info('Transmission successful (ACK received).')
        return True

    def _make_send_header(self, packet_size, sequence):
        assert packet_size in (128, 1024), packet_size
        _bytes = []
        if packet_size == 128:
            _bytes.append(ord(SOH))
        elif packet_size == 1024:
            _bytes.append(ord(STX))
        _bytes.extend([sequence, 0xff - sequence])
        return bytearray(_bytes)

    def _make_send_checksum(self, crc_mode, data):
        _bytes = []
        if crc_mode:
            crc = self.calc_crc(data)
            _bytes.extend([crc >> 8, crc & 0xff])
        else:
            crc = self.calc_checksum(data)
            _bytes.append(crc)
        return bytearray(_bytes)

    def recv(self, stream=None, default_filename=None, path=".",
             crc_mode=1, retry=16, timeout=2, delay=1, quiet=0):
        '''
        Receive a stream via the XMODEM protocol.

            >>> stream = open('/etc/issue', 'wb')
            >>> print(modem.recv(stream))
            2342

        Returns the number of bytes received on success or ``None`` in case of
        failure.

        :param stream: The stream object to write data to.
        :type stream: stream (file, etc.)
        :param crc_mode: XMODEM CRC mode
        :type crc_mode: int
        :param retry: The maximum number of times to try to resend a failed
                      packet before failing.
        :type retry: int
        :param timeout: The number of seconds to wait for a response before
                        timing out.
        :type timeout: int
        :param delay: The number of seconds to wait between resend attempts
        :type delay: int
        :param quiet: If ``True``, write transfer information to stderr.
        :type quiet: bool

        :param default_filename: Filename to save to if none is sent.
        :type default_filename: string

        :param path: Folder under which default_filename or protocol filename
                     will be used.
        :type path: string

        '''

        # initiate protocol
        self.crc_mode=crc_mode
        self.error_count = 0
        self.char = 0
        self.cancel = 0
        last_message=time.time()
        message_period=2.0 # emit progress every x seconds
        packet_size = 128

        # if we are given a stream, don't close it when returning
        if stream is not None:
            filename="<stream>"
            close_stream=False
        else:
            filename=None
            close_stream=True
        
        def sync():
            while True:
                # first try CRC mode, if this fails,
                # fall back to checksum mode
                if self.error_count >= retry:
                    self.log.info('error_count reached %d, aborting.', retry)
                    self.abort(timeout=timeout)
                    return False # trigger return
                elif self.crc_mode and self.error_count < (retry // 2):
                    # print("[sync will ask for CRC with 'C']")
                    if not self.putc(CRC):
                        self.log.debug('recv error: putc failed, '
                                       'sleeping for %d', delay)
                        time.sleep(delay)
                        self.error_count += 1
                    elif not self.putc(b'K'): # and ask for 1k packets.
                        self.log.debug('recv error: putc failed asking for 1k, '
                                       'sleeping for %d', delay)
                        time.sleep(delay)
                        self.error_count += 1
                else:
                    self.crc_mode = 0
                    # print("[sync will ask for checksum with a NAK]")
                    if not self.putc(NAK):
                        self.log.debug('recv error: putc failed, '
                                       'sleeping for %d', delay)
                        time.sleep(delay)
                        self.error_count += 1

                self.char = self.getc(1, timeout)
                if self.char is None:
                    self.log.warn('recv error: getc timeout in start sequence')
                    self.error_count += 1
                    continue
                elif self.char == SOH:
                    self.log.debug('recv: SOH')
                    break
                elif self.char == STX:
                    self.log.debug('recv: STX')
                    break
                elif self.char == CAN:
                    if self.cancel:
                        self.log.info('Transmission canceled: received 2xCAN '
                                      'at start-sequence')
                        return False
                    else:
                        self.log.debug('cancellation at start sequence.')
                        self.cancel = 1
                else:
                    self.error_count += 1
            return True # carry on
        
        if not sync(): return None
        
        # read data
        ymodem_data={}
        self.error_count = 0
        income_size = 0
        sequence = 1
        self.cancel = 0
        # threaded code can set this to True to abort
        self.abort_requested=False 
        
        while True:
            while True:
                # print("[top of inner while, self.char: %r]"%self.char)
                if self.abort_requested:
                    self.log.debug('aborting')
                    self.abort(count=5,timeout=10);
                    return None
                
                if self.char == SOH:
                    if packet_size != 128:
                        self.log.debug('recv: SOH, using 128b packet_size')
                        packet_size = 128
                    break
                elif self.char == STX:
                    if packet_size != 1024:
                        self.log.debug('recv: SOH, using 1k packet_size')
                        packet_size = 1024
                    break
                elif self.char == EOT:
                    # We received an EOT, so send an ACK and return the
                    # received data length.
                    self.putc(ACK)
                    self.log.info("Transmission complete, %d bytes",
                                  income_size)
                    if close_stream:
                        stream.close()
                        return filename,income_size
                    else:
                        return income_size
                elif self.char == CAN:
                    # cancel at two consecutive cancels
                    if self.cancel:
                        self.log.info('Transmission canceled: received 2xCAN '
                                      'at block %d', sequence)
                        return None
                    else:
                        self.log.debug('cancellation at block %d', sequence)
                        self.cancel = 1
                else:
                    err_msg = ('recv error: expected SOH, EOT; '
                               'got {0!r}'.format(self.char))
                    self.log.warn(err_msg)
                    self.error_count += 1
                    if self.error_count > retry:
                        self.log.error('error_count reached %d, aborting.',
                                      retry)
                        self.abort()
                        return None
                    else:
                        # print("Will try to re-sync")
                        if not sync(): return None
                        print("recovered sync -- okay")

            # read sequence
            self.error_count = 0
            self.cancel = 0
            self.log.debug('recv: data block %d', sequence)
            # print('[recv: data block %d]'%sequence)
            seq1 = self.getc(1, timeout)
            if seq1 is None:
                self.log.warn('getc failed to get first sequence byte')
                seq2 = None
            else:
                seq1 = ord(seq1)
                seq2 = self.getc(1, timeout)
                if seq2 is None:
                    self.log.warn('getc failed to get second sequence byte')
                else:
                    # second byte is the same as first as 1's complement
                    seq2 = 0xff - ord(seq2)
            # print("[about to get data block crc_mode is %s]"%self.crc_mode)
            # here we've gotten the right sequence characters,
            data=self.getc(packet_size + 1 + self.crc_mode, timeout)
            # but somehow crc is not correct?
            # print("[received %d bytes, data %s]"%(len(data),repr(data)))
            
            if self.ymodem and (seq1==seq2==0) and (sequence==1):
                #print("Got a YMODEM header")
                valid, data = self._verify_recv_checksum(self.crc_mode, data)
                if valid:
                    ymodem_parts=data.split(b"\0")
                    ymodem_data['filename']=ymodem_parts[0].decode('latin',errors='ignore')
                    ymodem_data['filesize_str']=ymodem_parts[1]
                    try:
                        ymodem_data['filesize']=int(ymodem_data['filesize_str'])
                    except ValueError:
                        print("Failed to parse %s as a filesize"%ymodem_data['filesize_str'])

                    print("YMODEM header had: ")
                    for k in ymodem_data:
                        print("  %20s=%s"%(k,ymodem_data[k]))
                    # For now, we don't mess with folders, just files
                    filename=os.path.join(path,os.path.basename(ymodem_data['filename']))
                    #print("Full header: ")
                    #print(repr(data))
                    
                    self.putc(ACK)
                    # seems that at this point XModem.cpp is expecting C, CK or NAK
                    # get next start-of-header byte
                    self.char = self.getc(1, timeout)
                    # print("After reading YMODEM head, next char with timeout=%s is "%timeout,end="")
                    # print(self.char)
                    continue
                else:
                    self.log.warning("Thought we'd get a ymodem packet, but CRC failed")
                    
            elif not (seq1 == seq2 == sequence):
                # we will discard the data
                # it is not the sequence we expected!
                self.log.error('expected sequence %d, '
                               'got (seq1=%r, seq2=%r), '
                               'receiving next block, will NAK.',
                               sequence, seq1, seq2)
            else:
                # sequence is ok, interpret packet
                # packet_size + checksum
                valid, data = self._verify_recv_checksum(self.crc_mode, data)

                # valid data, append chunk
                if valid:
                    # trim to known filesize if ymodem
                    if ('filesize' in ymodem_data) and (income_size+len(data)>ymodem_data['filesize']):
                        data=data[:(ymodem_data['filesize']-income_size)]
                    income_size += len(data)

                    # just in time opening of file:
                    if stream is None:
                        if filename is None:
                            filename=os.path.join(path,default_filename)
                        print("Saving to %s"%filename)
                        stream=open(filename,'wb')
                        
                    stream.write(data)

                    if time.time()-last_message>=message_period:
                        last_message=time.time()
                        if 'filesize' in ymodem_data:
                            total="%d"%ymodem_data['filesize']
                        else:
                            total="???"
                        print("%20s: %7d/%s bytes"%(filename, income_size, total))
                    
                    self.putc(ACK)
                    sequence = (sequence + 1) % 0x100
                    # get next start-of-header byte
                    self.char = self.getc(1, timeout)
                    continue

            # something went wrong, request retransmission
            self.log.warn('recv error: purge, requesting retransmission (NAK)')
            while True:
                # When the receiver wishes to <nak>, it should call a "PURGE"
                # subroutine, to wait for the line to clear. Recall the sender
                # tosses any characters in its UART buffer immediately upon
                # completing sending a block, to ensure no glitches were mis-
                # interpreted.  The most common technique is for "PURGE" to
                # call the character receive subroutine, specifying a 1-second
                # timeout, and looping back to PURGE until a timeout occurs.
                # The <nak> is then sent, ensuring the other end will see it.
                data = self.getc(1, timeout=1)
                if data is None:
                    break
            self.putc(NAK)
            # get next start-of-header byte
            self.char = self.getc(1, timeout)
            continue

    def _verify_recv_checksum(self, crc_mode, data):
        if crc_mode:
            _checksum = bytearray(data[-2:])
            their_sum = (_checksum[0] << 8) + _checksum[1]
            data = data[:-2]

            our_sum = self.calc_crc(data)
            valid = bool(their_sum == our_sum)
            if not valid:
                self.log.warn('recv error: checksum fail '
                              '(theirs=%04x, ours=%04x), ',
                              their_sum, our_sum)
        else:
            _checksum = bytearray([data[-1]])
            their_sum = _checksum[0]
            data = data[:-1]

            our_sum = self.calc_checksum(data)
            valid = their_sum == our_sum
            if not valid:
                self.log.warn('recv error: checksum fail '
                              '(theirs=%02x, ours=%02x)',
                              their_sum, our_sum)
        return valid, data

    def calc_checksum(self, data, checksum=0):
        '''
        Calculate the checksum for a given block of data, can also be used to
        update a checksum.

            >>> csum = modem.calc_checksum('hello')
            >>> csum = modem.calc_checksum('world', csum)
            >>> hex(csum)
            '0x3c'

        '''
        if platform.python_version_tuple() >= ('3', '0', '0'):
            return (sum(data) + checksum) % 256
        else:
            return (sum(map(ord, data)) + checksum) % 256

    def calc_crc(self, data, crc=0):
        '''
        Calculate the Cyclic Redundancy Check for a given block of data, can
        also be used to update a CRC.

            >>> crc = modem.calc_crc('hello')
            >>> crc = modem.calc_crc('world', crc)
            >>> hex(crc)
            '0xd5e3'

        '''
        for char in bytearray(data):
            crctbl_idx = ((crc >> 8) ^ char) & 0xff
            crc = ((crc << 8) ^ self.crctable[crctbl_idx]) & 0xffff
        return crc & 0xffff


XMODEM1k = partial(XMODEM, mode='xmodem1k')

class YMODEM(XMODEM):
    ymodem=True
    
def run():
    import optparse
    import subprocess

    parser = optparse.OptionParser(
        usage='%prog [<options>] <send|recv> filename filename')
    parser.add_option('-m', '--mode', default='xmodem',
                      help='XMODEM mode (xmodem, xmodem1k)')

    options, args = parser.parse_args()
    if len(args) != 3:
        parser.error('invalid arguments')
        return 1

    elif args[0] not in ('send', 'recv'):
        parser.error('invalid mode')
        return 1

    def _func(so, si):
        import select

        print(('si', si))
        print(('so', so))

        def getc(size, timeout=3):
            read_ready, _, _ = select.select([so], [], [], timeout)
            if read_ready:
                data = so.read(size)
            else:
                data = None

            print(('getc(', repr(data), ')'))
            return data

        def putc(data, timeout=3):
            _, write_ready, _ = select.select([], [si], [], timeout)
            if write_ready:
                si.write(data)
                si.flush()
                size = len(data)
            else:
                size = None

            print(('putc(', repr(data), repr(size), ')'))
            return size

        return getc, putc

    def _pipe(*command):
        pipe = subprocess.Popen(command,
                                stdout=subprocess.PIPE,
                                stdin=subprocess.PIPE)
        return pipe.stdout, pipe.stdin

    if args[0] == 'recv':
        getc, putc = _func(*_pipe('sz', '--xmodem', args[2]))
        stream = open(args[1], 'wb')
        xmodem = XMODEM(getc, putc, mode=options.mode)
        status = xmodem.recv(stream, retry=8)
        assert status, ('Transfer failed, status is', False)
        stream.close()

    elif args[0] == 'send':
        getc, putc = _func(*_pipe('rz', '--xmodem', args[2]))
        stream = open(args[1], 'rb')
        xmodem = XMODEM(getc, putc, mode=options.mode)
        sent = xmodem.send(stream, retry=8)
        assert sent is not None, ('Transfer failed, sent is', sent)
        stream.close()


        
if __name__ == '__main__':
    sys.exit(run())

# arduino is going to try to sync() again,
# but maybe this code wants to just go ahead
# with more packets?
# here we expect SOH, EOT, but get 'E' ??
# seems that XModem.cpp is wanting 'C', 'CK', or NAK,

# E is 69, 0x45
# 
# there is sort of a standoff, but the time to retry on the recv
# side was shorter than the full fail timeout on the send side.
# reduced recv timeout to 2s
# gets out of stalemate, but now gets CRC errors.

#
# seaduck>
# sb=DATA0024.BIN
# r<GOT YMODEM>[send b'C']1
# [recv,t0=2: b'\x01'][recv,t0=2: b'\x00'][recv,t0=2: b'\xff'][recv,t0=2: b'DATA0024]Got a YMODEM header
# YMODEM header had:  {'filename': b'DATA0024.BIN', 'filesize_str': b'2560', 'filesize': 2560}
# Full header: 
# b'DATA0024.BIN\x002560\x00\x00\x00\x00\x00\x00\x00\x00\x00\x00\x00\x00\x00\x00\x00\x00\x00\x00\x00\x00\x00\x00\x00\x00\x00\x00\x00\x00\x00\x00\x00\x00\x00\x00\x00\x00\x00\x00\x00\x00\x00\x00\x00\x00\x00\x00\x00\x00\x00\x00\x00\x00\x00\x00\x00\x00\x00\x00\x00\x00\x00\x00\x00\x00\x00\x00\x00\x00\x00\x00\x00\x00\x00\x00\x00\x00\x00\x00\x00\x00\x00\x00\x00\x00\x00\x00\x00\x00\x00\x00\x00\x00\x00\x00\x00\x00\x00\x00\x00\x00\x00\x00\x00\x00\x00\x00\x00\x00\x00\x00\x00'
# [send b'\x06']1
#   that's ACK, which XModem.cpp will read but discard

# Now python wants to grab a character to mark the start of the next frame -- but
# arduino tries to sync(), which will wait for a 'C','CK' or NAK from python.

# [recv,t0=2: None]After reading YMODEM head, next char with timeout=2 is None
# recv error: expected SOH, EOT; got None

# So python goes into sync(), which should start by sending a 'C'

# Will try to re-sync
# [send b'\x15']1

# python just sent its 'C'
                      
# recv error: checksum fail (theirs=ce, ours=d5)
# recv error: purge, requesting retransmission (NAK)
# [recv,t0=2: b'\x01'][recv,t0=2: b'\x01'][recv,t0=2: b'\xfe'][recv,t0=2: b"[('imu_e][recv,t0=1: b't'][recv,t0=1: None][send b'\x15']1
# recv error: checksum fail (theirs=ce, ours=d5)
# recv error: purge, requesting retransmission (NAK)
# [recv,t0=2: b'\x01'][recv,t0=2: b'\x01'][recv,t0=2: b'\xfe'][recv,t0=2: b"[('imu_e][recv,t0=1: b't'][recv,t0=1: None][send b'\x15']1
# recv error: checksum fail (theirs=ce, ours=d5)
# recv error: purge, requesting retransmission (NAK)
# [recv,t0=2: b'\x01'][recv,t0=2: b'\x01'][recv,t0=2: b'\xfe'][recv,t0=2: b"[('imu_e][recv,t0=1: b't'][recv,t0=1: None][send b'\x15']1
# recv error: checksum fail (theirs=ce, ours=d5)
# recv error: purge, requesting retransmission (NAK)
# [recv,t0=2: b'\x01'][recv,t0=2: b'\x01'][recv,t0=2: b'\xfe'][recv,t0=2: b"[('imu_e][recv,t0=1: b't'][recv,t0=1: None][send b'\x15']1
# recv error: checksum fail (theirs=ce, ours=d5)
# recv error: purge, requesting retransmission (NAK)
# [recv,t0=2: b'\x01'][recv,t0=2: b'\x01'][recv,t0=2: b'\xfe'][recv,t0=2: b"[('imu_e][recv,t0=1: b't'][recv,t0=1: None][send b'\x15']1
# recv error: expected SOH, EOT; got b'E'
# recv error: expected SOH, EOT; got b'E'
# [recv,t0=2: b'E']Will try to re-sync
# [send b'\x15']1
# [recv,t0=2: b'r'][send b'\x15']1
# [recv,t0=2: b'r'][send b'\x18']1
# [send b'\x18']1
# 
# XMODEM result: None
# or sending...
# seaduck>

# is it possible XModem.cpp is using CRC, but xmodem.py is using checksum?
#  there is an extra 't' that gets sent, might be part of a CRC?
# XModem.cpp: 	oldChecksum =  (inChar == NAK), where inChar comes from the sync()
#     maybe fixed an issue where XModem.cpp would slip back into CRC.
# behavior unchanged.
#   python is sending 0x15 (NAK)
#   gets 0x01 in return

# arduino should be sending SOH for packetlength of 128,
# or STX for packetlength of 1024
# that part is good - we get 0x01==SOH, for a 128 byte packet.

# but it seems like we are synced up on checksum -
# arduino sends '$' which is debugging for checksum,
# 

# when I copy the string over and sum it manually I get 0xd5
# or 0x2a if 255-x, same as ~
# that matches what xmodem.py is printing.
# okay - so xmodem.py doesn't xor it, but XModem.cpp does.
#
