rustychris/minictd/firmware/sketches/cond_spec/Sensor.cpp

#include "Sensor.h"
#include "serialmux.h"

#pragma GCC optimize ("O0")

IntervalTimer sensorTimer(4);

void Sensor::read() {
  push_busy();
  async_read();
  while(busy);
}

void Sensor::clear_busy(void) {
  busy--;
    
  if(busy<0) {
    mySerial.println("Busy went negative");
    // while(1);
  }
}

void Sensor::push_busy(void) {
  if (busy>0) {
    mySerial.println("FAIL busy is already nonzero");
  }
  busy++;
  // this line causes an internal compiler error for M0.
  //push_fn(this,(SensorFn)(&Sensor::clear_busy));
  // but this is okay.
  push_fn(this,&Sensor::clear_busy);
}

binary_format_t binary_format;

uint8_t hexmap[]={'0','1','2','3','4','5','6','7',
                  '8','9','A','B','C','D','E','F'};

// including null
#define HEX_CHAR_PER_LINE 513

void write_base16(Print &out,uint8_t *buff,int count)
{
  static uint8_t hexbuff[HEX_CHAR_PER_LINE];

  int i=0; // tracks index into buff.
  int pos=0; // tracks next index into hexbuff

  if( binary_format==BIN_HEX) {
    for(;i<count;i++) {
      hexbuff[pos]  =hexmap[ (buff[i]>>4) & 0xF ];
      hexbuff[pos+1]=hexmap[  buff[i]     & 0xF ];
      pos+=2;
      // wrap lines
      if( pos == HEX_CHAR_PER_LINE-1 ) {
        hexbuff[pos]='\n';
        out.write(hexbuff,HEX_CHAR_PER_LINE);
        pos=0;
      }
    }
    if( pos > 0 ){
      // avoid so many newlines
      // hexbuff[pos]='\n';
      out.write(hexbuff,pos);
    }
  } else {
    out.write(buff,count);
  }
}

// State that goes with the function stack
volatile int fn_stack_i=0; // first unallocated
volatile SensorClosure fn_stack[FN_STACK_MAX];

int stack_size(void) {
  return fn_stack_i;
}

void push_fn(Sensor *s, SensorFn fn)
{
  if (fn_stack_i>=FN_STACK_MAX) {
    mySerial.println("Sensor stack overflowed");
    while(1);
  }
  fn_stack[fn_stack_i].s=s;
  fn_stack[fn_stack_i].fn=fn;
  
  fn_stack_i++;
}

void pop_fn() {
  // This is mostly for debugging, so leave it verbose
  mySerial.println("Pop no call");
  if( fn_stack_i > 0 ){
    fn_stack_i--;
  } else {
    mySerial.println("Stack empty");
  }
}

void pop_fn_and_call() {
  // May need to rethink some of this, possibly protect this from
  // reentrance or competing calls to push_fn().
  if( fn_stack_i > 0 ){
    fn_stack_i--;
    // it's allowable to pass NULL in for the object, which is
    // essentially a NOP, and a cheap pseudo-semaphore
    if( fn_stack[fn_stack_i].s != NULL ) {
      // Yuck!!
      ((fn_stack[fn_stack_i].s)->*(fn_stack[fn_stack_i].fn))();
    }
  }
}
