rustychris/minictd/firmware/sketches/cond_spec/cfg_motor.h

#define HAS_DRV8833
#define HAS_MOTOR

// digital outputs for the motor
#define MOTOR_A1 9
#define MOTOR_A2 10 
#define MOTOR_B1 A1
#define MOTOR_B2 11
#define MOTOR_ASENSE A3
#define MOTOR_BSENSE A4
#define MOTOR_ASENSE_R 0.47
#define MOTOR_BSENSE_R 0.47

#define MOTOR_nSLEEP 2
