rustychris/minictd/firmware/sketches/cond_spec/cfg_buoyancy.h

#define HAS_BUOYANCY

// which motor output is being used
#define BUOY_MTR_SEL MOTOR_A

#define BUOY_MTR_POS MOTOR_REV
#define BUOY_MTR_NEG MOTOR_FWD

// range of displacement in ml
#define BUOY_PISTON_ML 5

// ml/s.  Calculated from RPM, leadscrew pitch, piston diameter
#define PISTON_RATE 0.055
