rustychris/minictd/firmware/sketches/cond_spec/rtclock.h

#ifndef RTCLOCK_H
#define RTCLOCK_H

#ifdef RTC_TEENSY

#include "Sensor.h"

class RTClock : public Sensor {
public:
  RTClock() {
    strcpy(name,"realtimeclock");
  }
  
  virtual void init();
  virtual void async_read();

  virtual bool dispatch_command(const char *cmd, const char *cmd_arg);
  virtual void help();
  virtual void write_frame_info(Print &out);
  virtual void write_data(Print &out);
  
  // unsigned long reading_seconds;
  time_t reading_seconds;
  unsigned int reading_partial;

  void status();
  void watch();
};

#endif // RTC_TEENSY
#endif // RTCLOCK_H
