rustychris/minictd/firmware/sketches/cond_spec/cfg_cond.h

// hardware parameters for conductivity cell
#define HAS_CONDUCTIVITY

#define CDRIVE1 11
#define CDRIVE2 12
#define CCSENSE1 A12
#define CCSENSE2 A13
#define CVSENSE1 A10
#define CVSENSE2 A11

#define RSENSE 10
#define CELL_CONSTANT 15.0

// This gain reflects the inamp gain
#define CGAIN (10)
