rustychris/minictd/firmware/sketches/cond_spec/conductivity.h

#ifndef CONDUCTIVITY_H
#define CONDUCTIVITY_H

#include "Sensor.h"

// 48 MHz
#define PDB_F0 (44100*1087)

class Conductivity : public Sensor {
public:
  bool log_full_scan;
  bool log_reduced_scan;
  
  Conductivity();
  
  void init();
  virtual void async_read();

  void scan_setup();
  
  void dac_status();
  void fill_sine_buffer();
  void adc_setup();
  void adc0_setup();
  void adc1_setup(void);
  void dac_setup(void);
  void pdb_setup(void);

  void scan_cleanup();
  void pdb_stop(void);
  void adc_stop(void);
  void dac_stop();

  void wait_for_scan();
  void scan();
  void scan_dump();
  void scan_reduce();

  int real_freq_hz();
  
  virtual bool dispatch_command(const char *, const char *);
  virtual void help();

  virtual void write_frame_info(Print &out);
  virtual void write_data(Print &out);
  
  float reading; // would it be better for this to be a scaled int?

  // async support
  void async_scan_post(); 
};

#endif // CONDUCTIVITY_H
