rustychris/minictd/(commit log)

2017-06-13 initial import
    [logger_01.dsn, logger_01.kicad_pcb, logger_01.sch]
2017-07-04 add teensyduino code to repo
2017-07-04 adding pcb for sensor head
    [sensor_head.kicad_pcb, sensor_head.sch]
2017-07-04 minor pcb doc changes
    [logger_01.kicad_pcb, logger_01.sch]
2017-08-03 Long overdue update.
    [logger_01.sch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]
2017-09-20 Fixed pin config for pressure, SD card.
    Can read pressure, SD card, thermistor, cond. cell.
    [SdFunctions.h, SeaDuck.cpp, SeaDuck.h, cond_spec.ino, ms5803.cpp, pressure.cpp, pressure.h]
2017-12-06 Add binary streaming, other fixes and refactors
    [cond_scan.py, conductivity.cpp, conductivity.h, device.py, read_scans.py, seaduck_cfg.h, test_pressure.ino]
2017-12-23 Refactor Sensor, new commands.
2018-01-02 Start on async transition for pressure.
2018-01-04 Working async pressure.
2018-10-11 many adaptations to feather board
2018-10-14 Basic boot now working.
    Successfully reads pressure, SD card, fake RTC.
2018-10-30 Add IMU support, BNO055
2018-11-01 non-working async i2c
2018-11-01 Async i2c working via DMAC
2018-11-02 Transition back to standard I2C pins
2018-11-02 Refactoring and using standard i2c
2018-11-03 Basic IMU working
2018-11-08 Fix timer conflict, add green led while sampling
    [SeaDuck.cpp, Sensor.cpp, cfg_seaduck.h, imu.cpp, imu.h, ms5803.cpp, rtc_ds3231.cpp, samd_IntervalTimer.cpp]
2018-11-28 GPS, pcb layout
    [3727 ItsyBitsy M0.step, Adafruit_BNO055_AP203.STEP, Battery Samsung ICR 18650 -22E.step, DM3AT-SF-PEJM5.step, Micro SD Card.STEP, keystone-PN500.STEP, m0_logger.kicad_pcb, m0_logger.sch]
2018-12-10 PCB layout sent, minor CAD for housing
    [m0_logger.kicad_pcb, pvc-1.25inch.fcstd]
2018-12-18 Start layout of next board revision
    [m0_logger-bom.csv, m0_logger.kicad_pcb, m0_logger.sch]
2018-12-19 Finish layout for 2nd revision
    [m0_logger.kicad_pcb, m0_logger.sch]
2018-12-20 rev2 submitted
    [m0_logger.kicad_pcb, m0_logger.sch]
2019-01-20 Initial motor code, successfully tested.
2019-01-29 Test RTC, imu, fix some documentation and missing commands.
    All aspects of board check out.
    [SeaDuck.cpp, cfg_seaduck.h, cond_spec.ino, gps.cpp, motor.cpp, motor.h, rtc_ds3231.cpp, rtc_ds3231.h]
2019-02-25 Tweaks while testing new boards
2019-03-11 GPS logging fix to remove null bytes
    [Sensor.cpp, gps.cpp]
2019-03-14 Simulation code for buoyancy, config for buoyancy
    [m0_logger-with_pressure.kicad_pcb, m0_logger.sch]
2019-03-14 Fix gravity term, and switch to canned integration
2019-03-21 Update PID Controller to command piston volume.
    Previously PID controller commanded motor on/off.
2019-03-22 Fix cruft at start of files. Also more PID output
    [SeaDuck.cpp, buoyancy.cpp, buoyancy.h, motor.cpp, motor.h]
2019-03-24 More debug messages, avoid resetting motor position, and force neutral between fwd and rev.
    [buoyancy.cpp, motor.cpp, motor.h]
2020-03-24 progress on samd21 dac-adc loop
